Ryan-Fagan/QuadcopterPCB/docs/ComponentDiagram.png

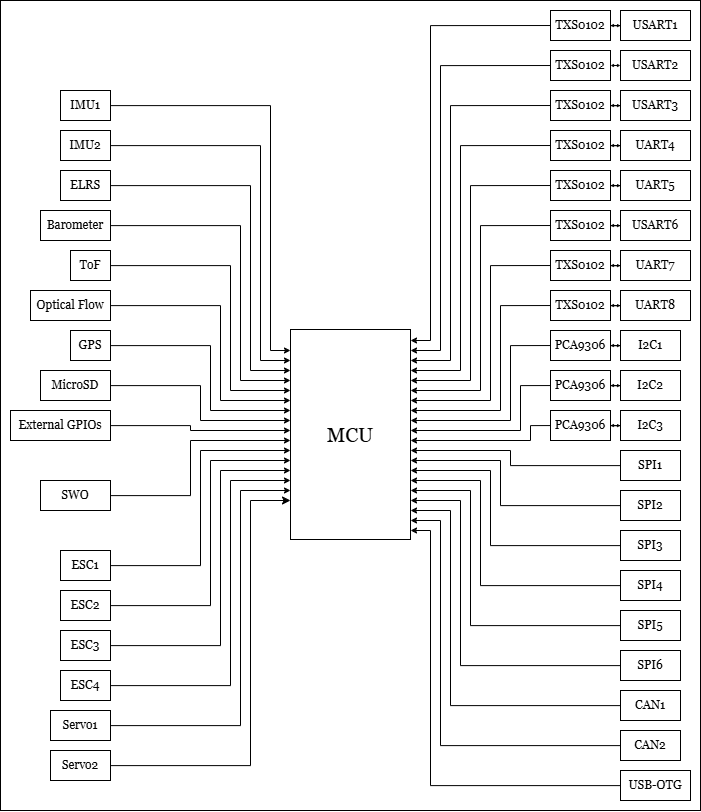
docs/ComponentDiagram.png
