Ryan-Fagan/QuadcopterPCB/docs/DroneSchematic.pdf

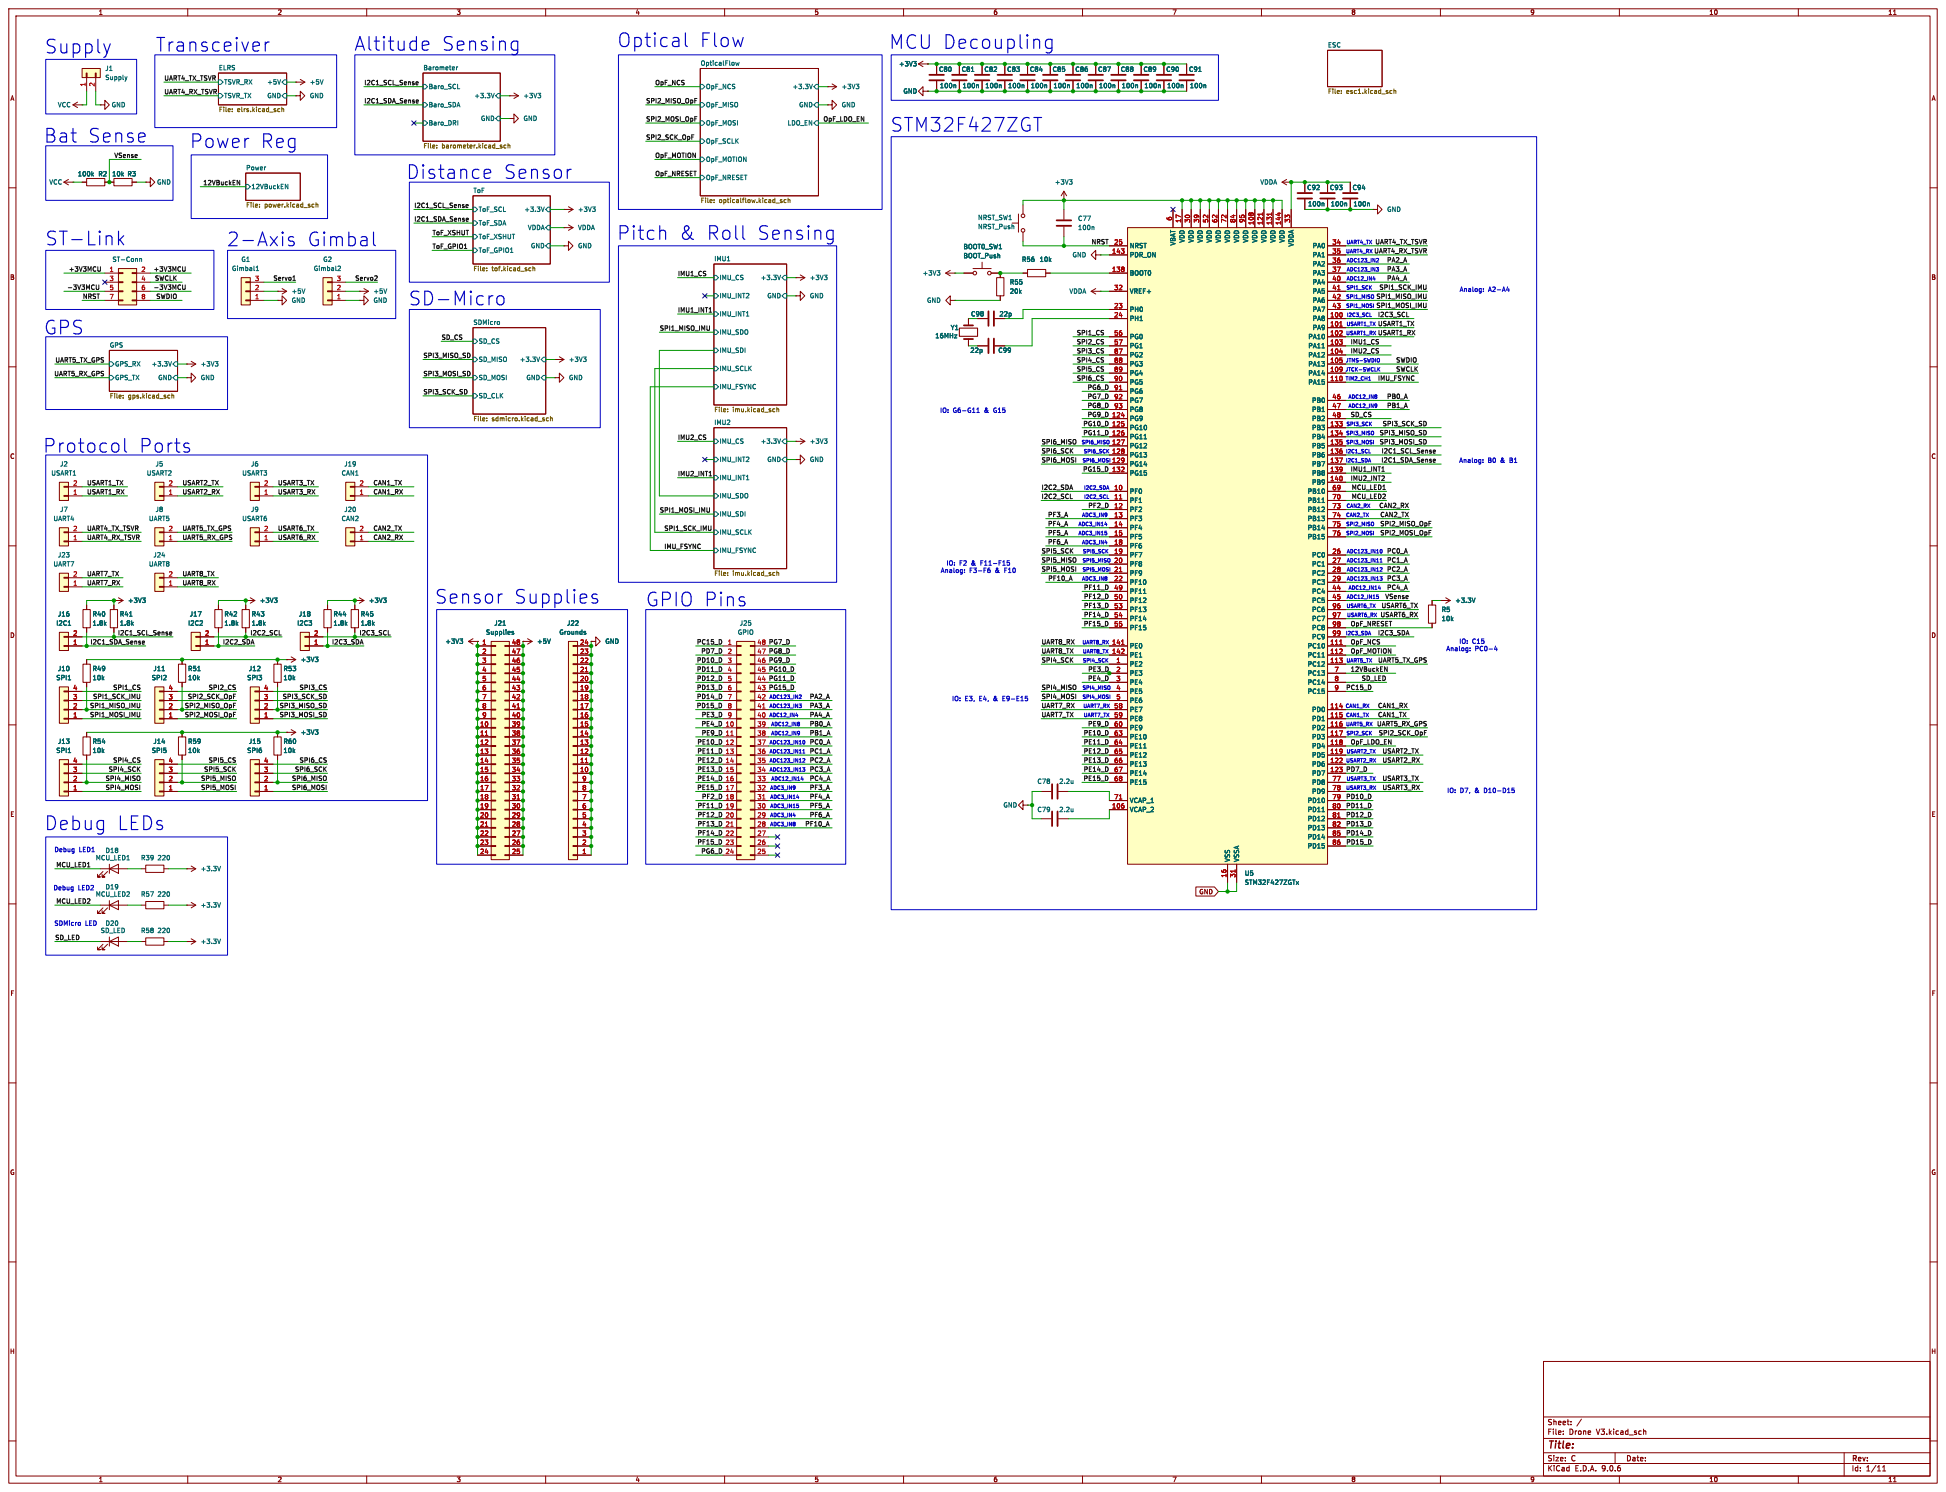
[picture p2: page 1]

JTCK-SWCLK Power Reg

6 VDD 17 VDD 30 VDD 39 VDD 52 VDD 62 VDD 72 VSS 16 VDD 84 VSSA 31 VDD 95 VDD 108 VDD 121 VDD 131 VDD 144 VDDA 33 PA0

Debug LED1 Debug LED2 SDMicro LED

Id: 1/11 Title: File: Drone V3.kicad_sch Sheet: /

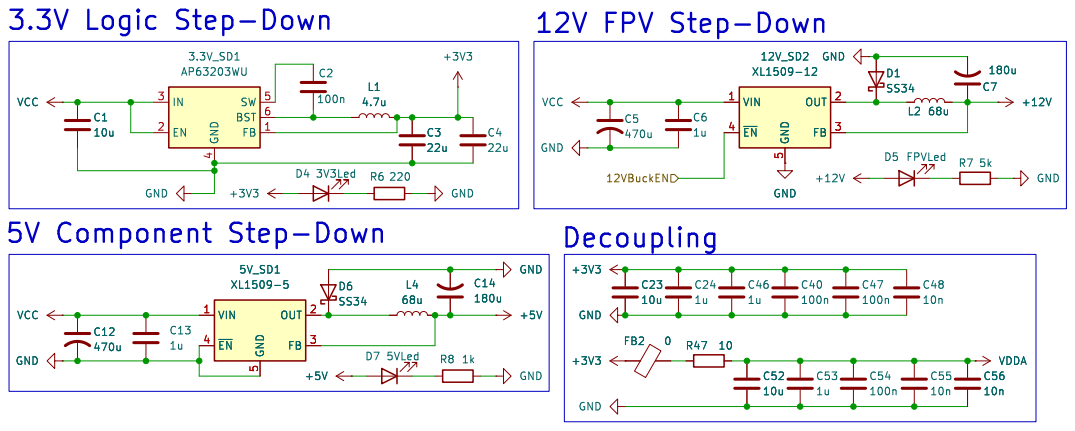
[picture p3: page 2]

Id: 2/11 Title: File: power.kicad_sch Sheet: /Power/

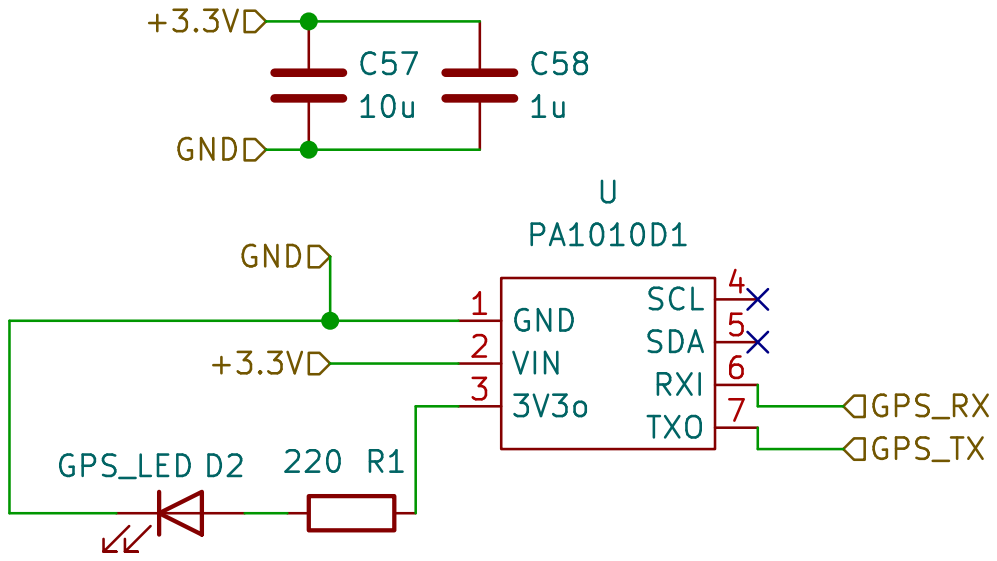
[picture p4: page 3]

Id: 3/11 Title: File: gps.kicad_sch Sheet: /GPS/

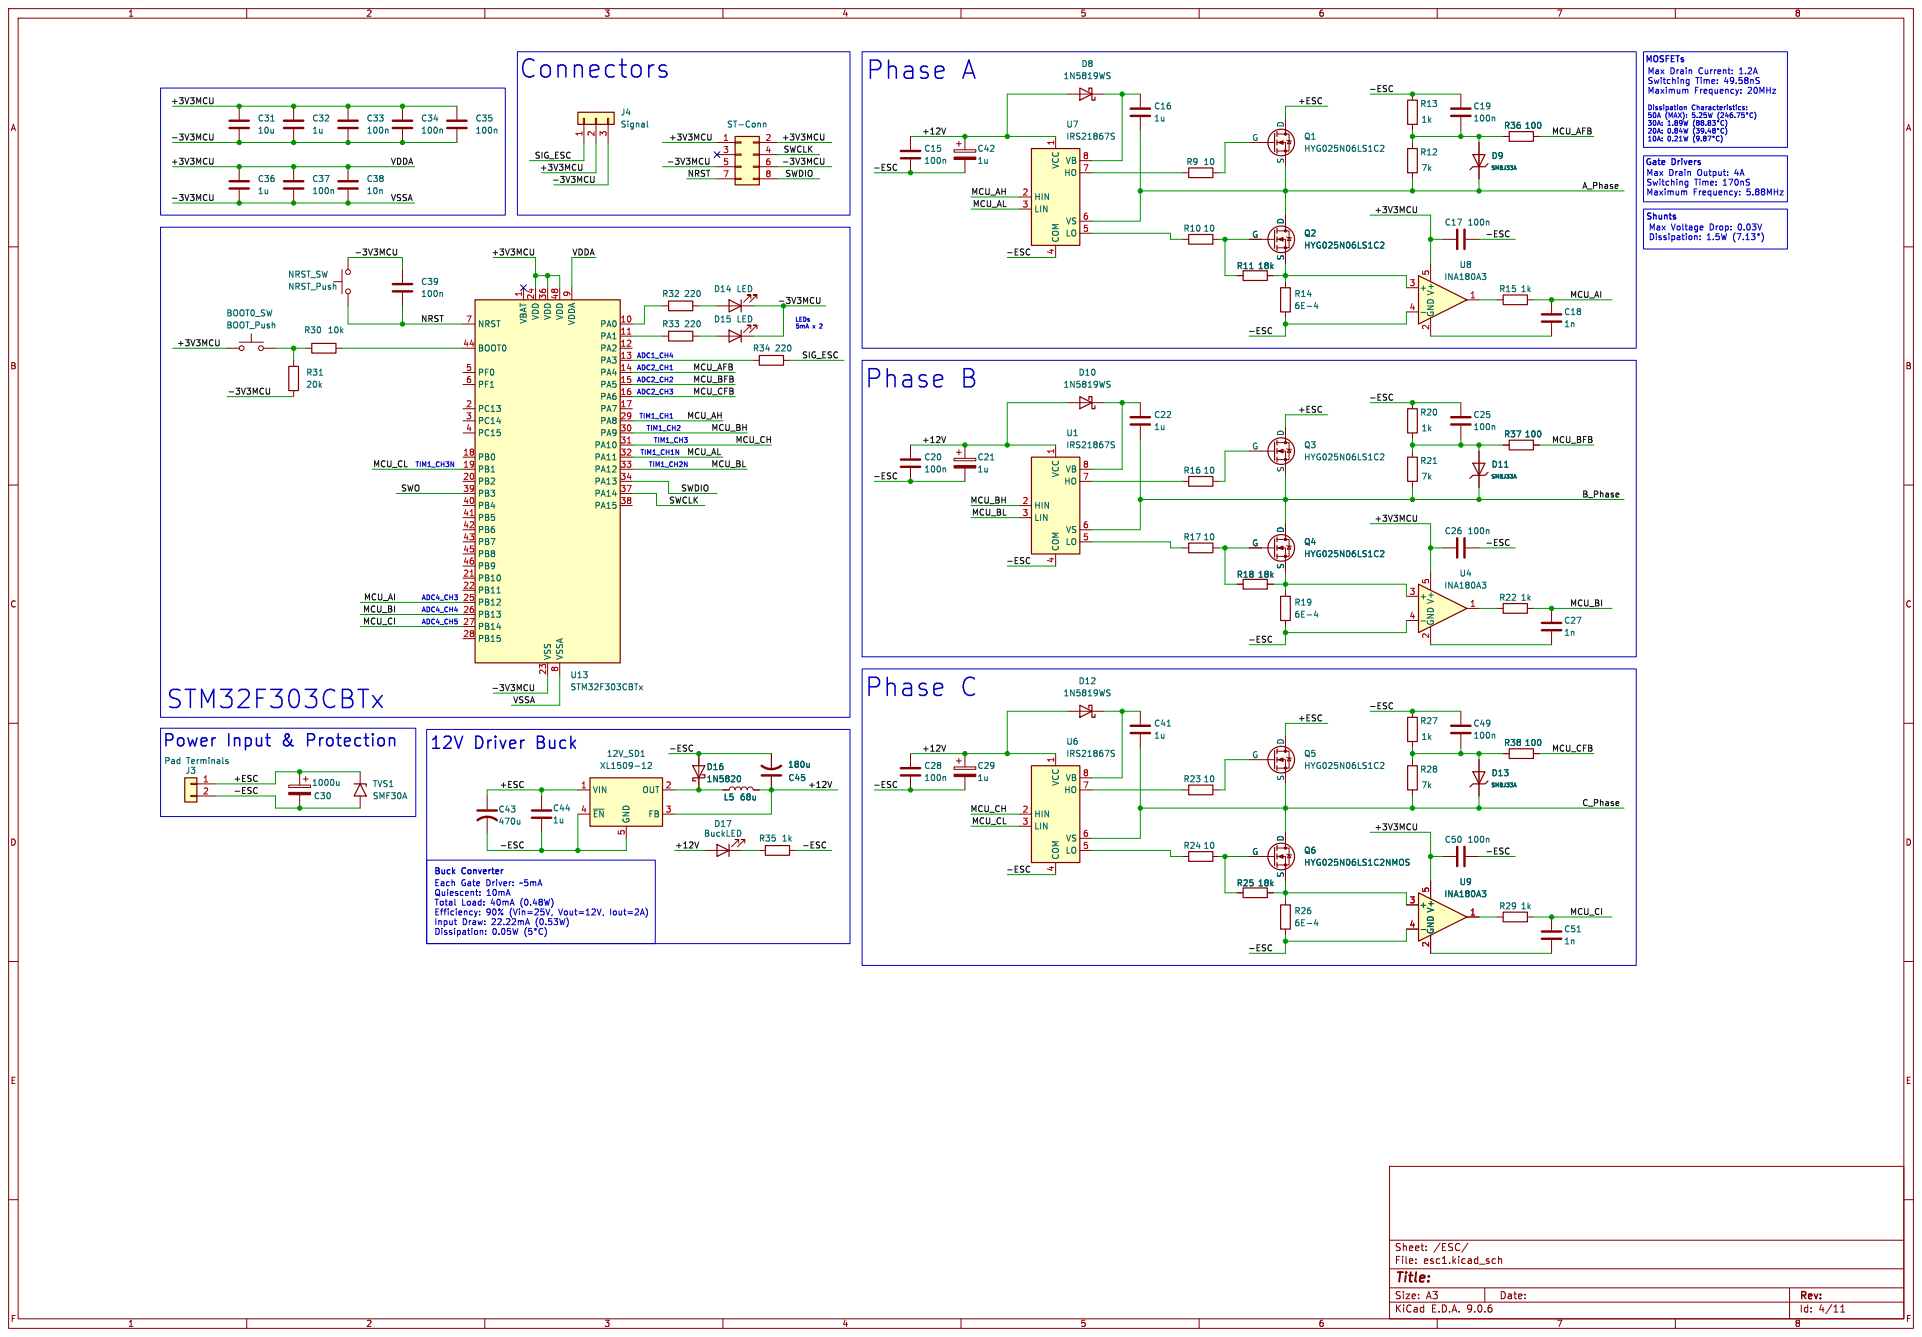
[picture p5: page 4]

1 VDD 24 VDD 36 VSS 23 VDD 48 VSSA

Id: 4/11 Title: File: esc1.kicad_sch Sheet: /ESC/

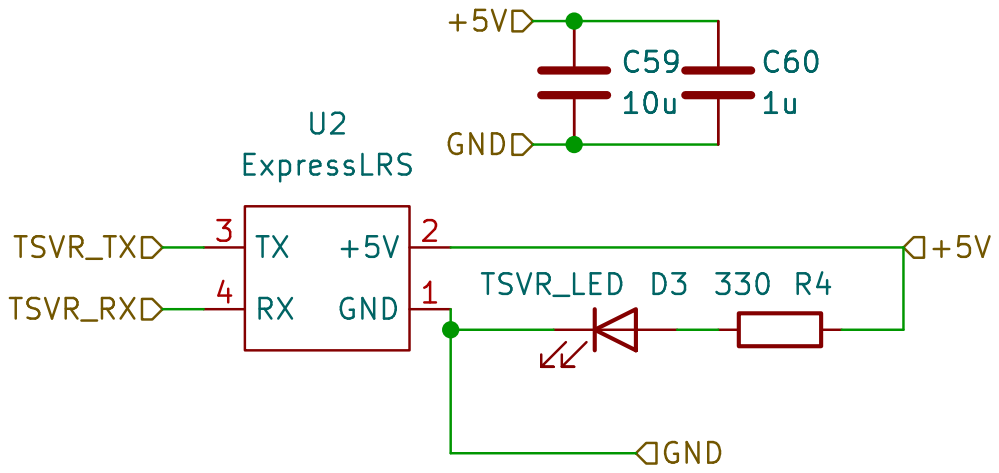
[picture p6: page 5]

Id: 5/11 Title: File: elrs.kicad_sch Sheet: /ELRS/

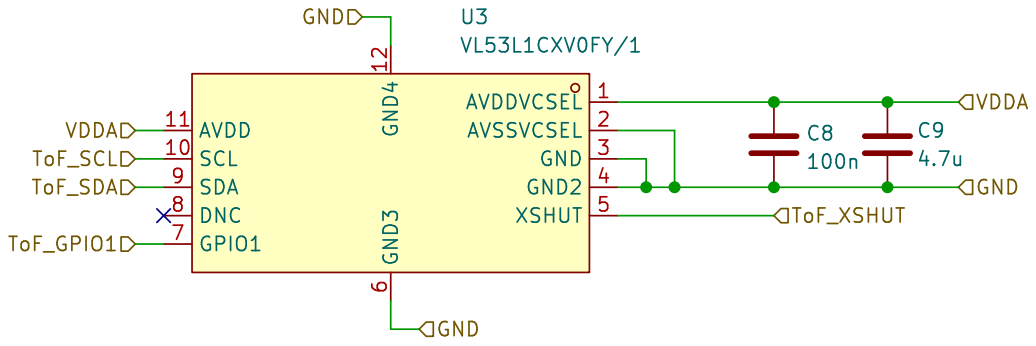
[picture p7: page 6]

6 GPIO1 7 DNC 8 XSHUT 5 SDA 9 GND2 4 SCL 10 GND 3 AVDD 11 AVSSVCSEL 2 AVDDVCSEL 1 GND4 12 U3VL53L1CXV0FY/1 C9

Id: 6/11 Title: File: tof.kicad_sch Sheet: /ToF/ C8

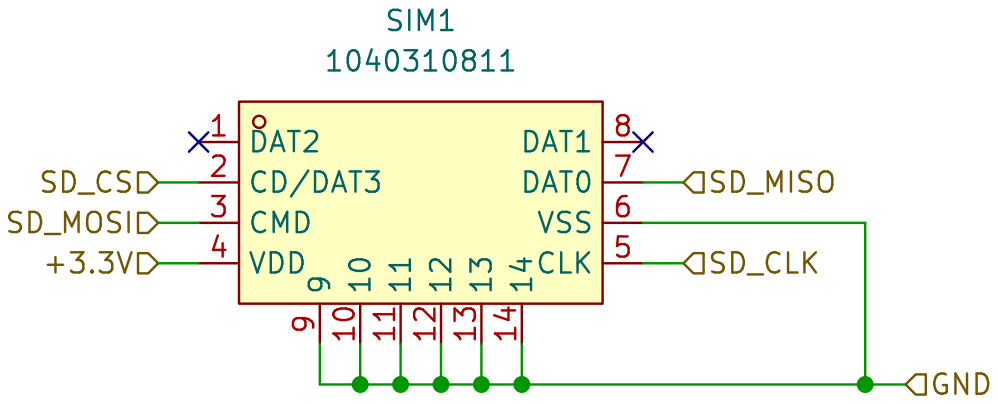
[picture p8: page 7]

Id: 7/11 Title: File: sdmicro.kicad_sch Sheet: /SDMicro/

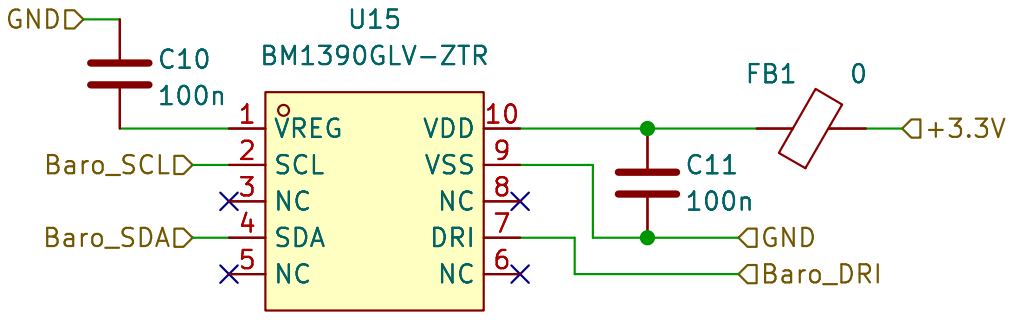
[picture p9: page 8]

Id: 8/11 Title: File: barometer.kicad_sch Sheet: /Barometer/

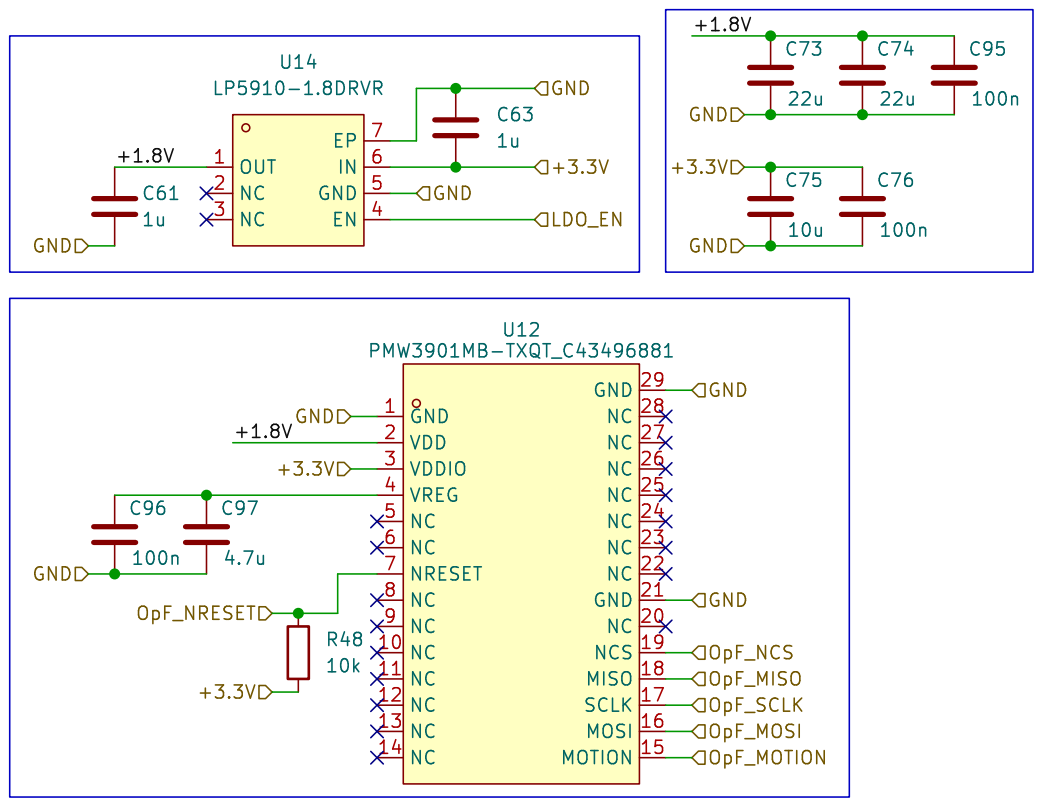
[picture p10: page 9]

Id: 11/11 Title: File: opticalflow.kicad_sch Sheet: /OpticalFlow/

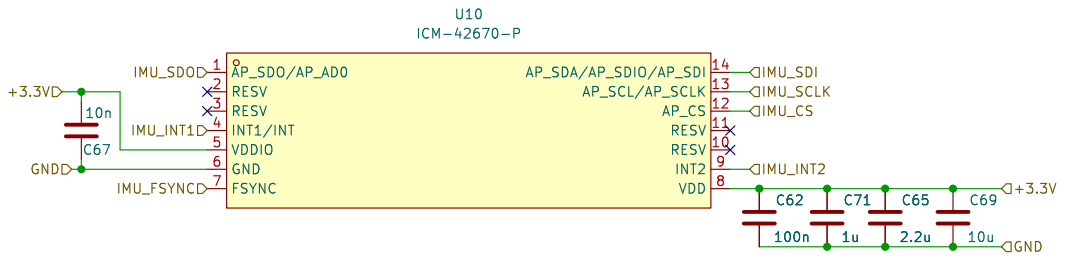
[picture p11: page 10]

Id: 11/11 Title: File: imu.kicad_sch Sheet: /IMU1/ C62

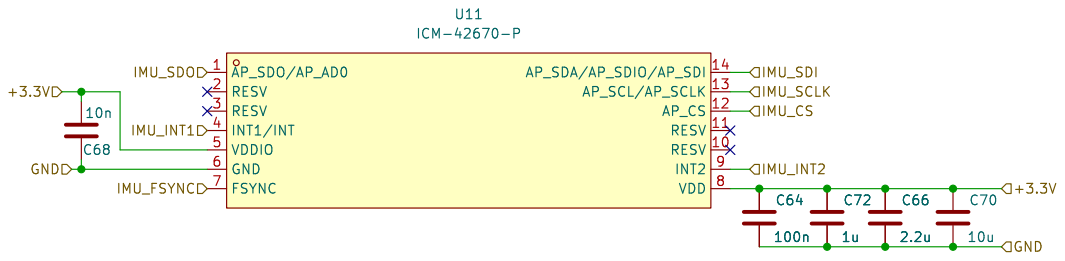
[picture p12: page 11]

Id: 12/11 Title: File: imu.kicad_sch Sheet: /IMU2/ C64
