Ryan-Fagan/QuadcopterPCB/(list of files, drawings)

Other design files:
freerouting.dsn
