Ryan-Fagan/QuadcopterPCB/Drone V3.kicad_pcb

## KiCad design Drone V3.kicad_pcb (2026-05-14)

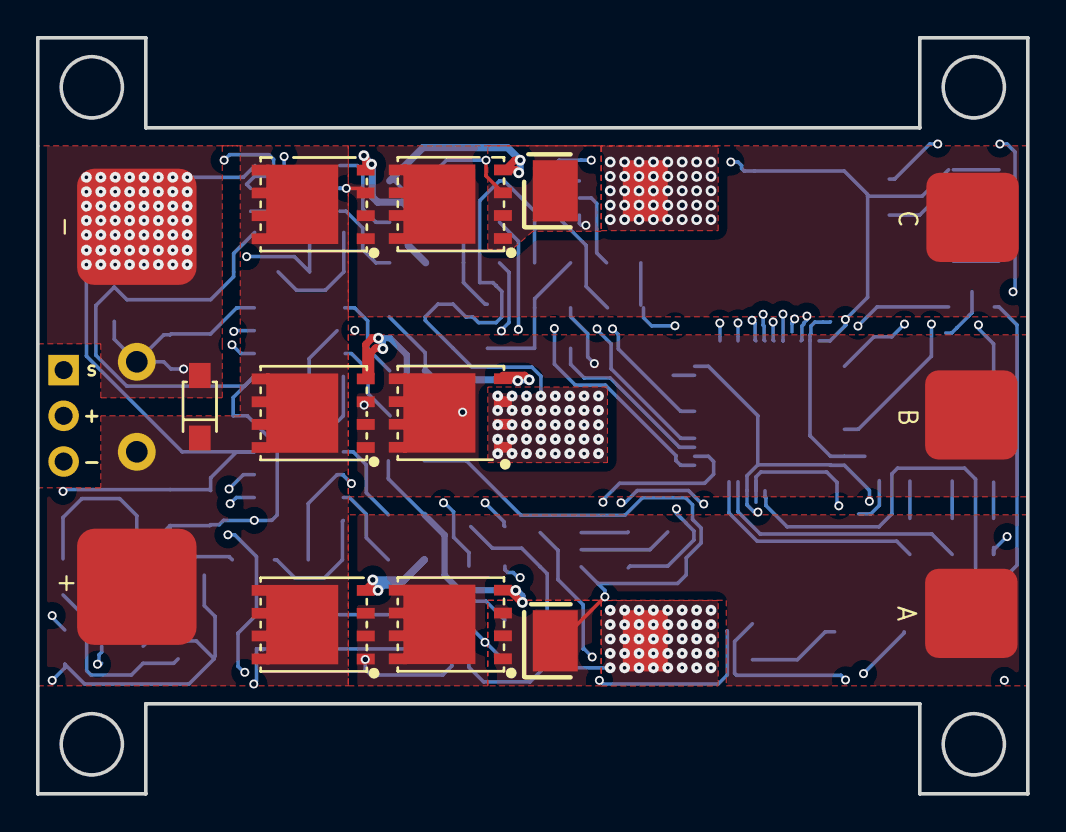
[picture p13: board Drone V3.kicad_pcb from above]

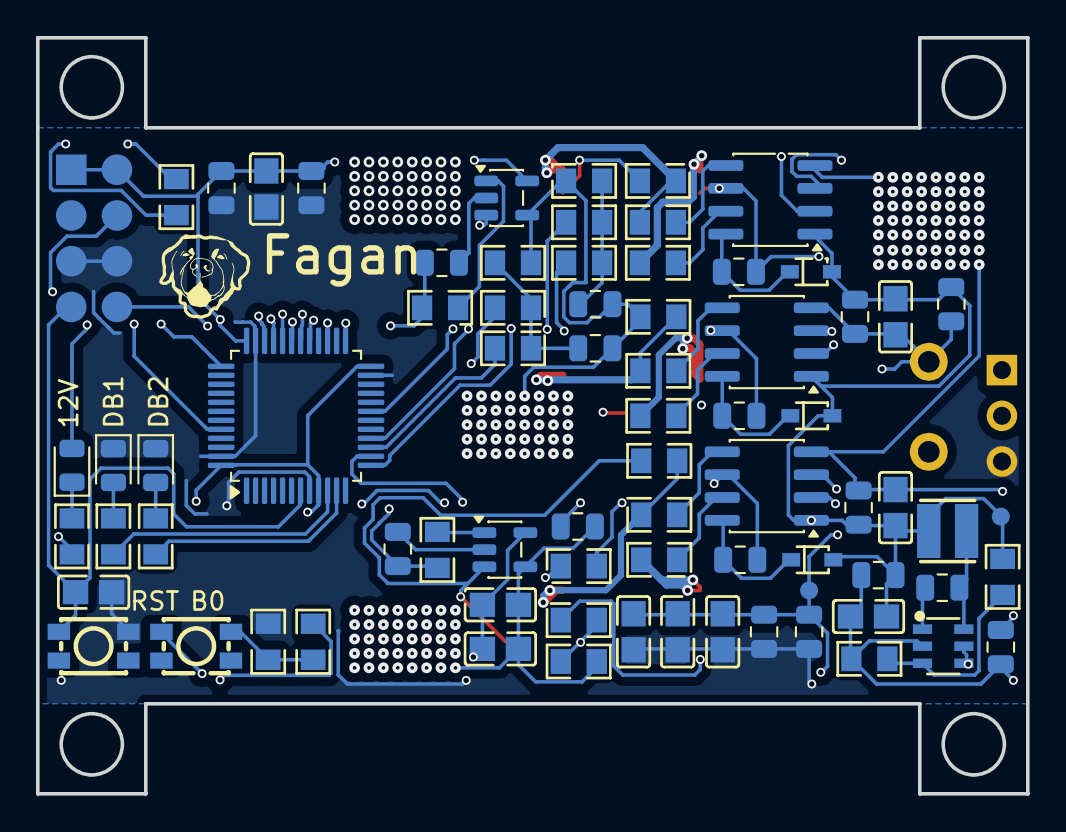
[picture p14: board Drone V3.kicad_pcb from below]

Board: 4 copper layers, 55.0 x 42.0 mm, 86 parts (75 on the bottom side), 59 nets.

Parts:
12V_SD1: TPS560430; SOT-23-6_L2.9-W1.6-P0.95-LS2.8-BL
B0: BOOT_Push; SW-SMD_4P-L3.5-W3.0-P1.50-LS4.7
C15, C20, C26, C28, C29, C33, C34, C35, C37, C39: 100n; C0805
C16, C21, C22, C23, C24, C32, C36, C41: 1u; C_0805_2012Metric
C19, C25, C27, C40, C49: 22n; C_0805_2012Metric
C30: 1000u; CAP-TH_BD12.5-P5.00-D0.6-FD
C31, C45: 10u; C_0805_2012Metric
C38: 10n; C_0805_2012Metric
C42: 2.2u; C_0805_2012Metric
C43: 100n; C_0805_2012Metric
D8, D10, D12: 1N5819WS; SOD-323_L1.8-W1.3-LS2.5-RD
D14, D15: LED; LED_0805_2012Metric
D17: BuckLED; LED_0805_2012Metric
J2: Phase Outputs; ESC Outputs
J3: Pad Terminals; Battery Inputs
J4: Signal; PinHeader_1x03_P2.54mm_Horizontal
L6: 33u; IND-SMD_L3.0-W3.0_LQH3NPN2R2NG0L
NMOS1, NMOS2, NMOS3, NMOS4, NMOS5, NMOS6: HYG025N06LS1C2; DFN-8_L5.9-W5.2-P1.27-LS6.2-BL
R9, R10, R16, R17, R23, R24: 10; R0805
R11, R18, R25, R31: 47k; R0805
R12, R21, R28: 36k; R0805
R13, R20, R27, R30, R35: 5k; R0805
R19, R26: 6E-4; RES-SMD_L6.4-W3.2_LRS2512
R22, R29, R32, R33, R34, R36, R37, R38: 220; R0805
R39: 243; R0805
R40: 22.1; R0805
RST: NRST_Push; SW-SMD_4P-L3.5-W3.0-P1.50-LS4.7
ST-Link1: ST-Conn; PinHeader_2x04_P2.54mm_Vertical
TVS1: SMF30A; SOD-123FL_L2.7-W1.8-LS3.8-RD
U1, U6, U7: IRS21867S; SOIC-8_3.9x4.9mm_P1.27mm
U4, U9: INA180A3; SOT-23-5
U13: STM32F303CBTx; LQFP-48_7x7mm_P0.5mm

Connections:
/ESC1/+3V3MCU: B0.1, C26.1, C29.1, C31.1, C32.1, C33.1, C34.1, C35.1, C36.1, C37.1, C38.1, J4.2, ST-Link1.1, ST-Link1.2, U4.5 (V+), U9.5 (V+), U13.9 (VDDA), U13.24 (VDD), U13.36 (VDD), U13.48 (VDD)
/ESC1/+12V: C15.1, C20.1, C21.1, C23.1, C24.1, C28.1, C45.1, D8.2 (A), D10.2 (A), D12.2 (A), D17.2 (A), L6.2, R39.1, U1.1 (VCC), U6.1 (VCC), U7.1 (VCC)
/ESC1/+ESC: C30.1, J3.1, NMOS1.1 (D), NMOS3.1 (D), NMOS5.1 (D), TVS1.1 (A1)
/ESC1/-3V3MCU: C31.2, C32.2, C33.2, C34.2, C35.2, C36.2, C37.2, C38.2, C39.1, D14.1 (K), D15.1 (K), J4.3, R31.1, RST.2, ST-Link1.5, ST-Link1.6, U13.8 (VSSA), U13.23 (VSS), U13.35 (VSS), U13.47 (VSS)
/ESC1/-ESC: 12V_SD1.2 (GND), C15.2, C19.1, C20.2, C21.2, C23.2, C24.2, C25.1, C26.2, C28.2, C29.2, C30.2, C42.2, C45.2, C49.1, J3.2, NMOS4.3 (S), R13.1, R18.2, R19.2, R20.1, R26.2, R27.1, R35.2, R40.2, TVS1.2 (A2), U1.4 (COM), U4.4 (-), U6.4 (COM), U7.4 (COM), U9.4 (-)
/ESC1/A_Phase: C16.2, J2.1, NMOS1.3 (S), NMOS2.1 (D), R12.2, U7.6 (VS)
/ESC1/BUCK_FB: 12V_SD1.3 (FB), R39.2, R40.1
/ESC1/BUCK_SW: 12V_SD1.6 (SW), C43.1, L6.1
/ESC1/B_Phase: C22.2, J2.2, NMOS3.3 (S), NMOS4.1 (D), R21.2, U1.6 (VS)
/ESC1/C_Phase: C41.2, J2.3, NMOS5.3 (S), NMOS6.1 (D), R28.2, U6.6 (VS)
/ESC1/MCU_AFB: R36.2, U13.14 (PA4)
/ESC1/MCU_AH: U7.2 (HIN), U13.29 (PA8)
/ESC1/MCU_AI: C40.1, R29.2, U13.25 (PB12)
/ESC1/MCU_AL: U7.3 (LIN), U13.32 (PA11)
/ESC1/MCU_BFB: R37.2, U13.15 (PA5)
/ESC1/MCU_BH: U1.2 (HIN), U13.30 (PA9)
/ESC1/MCU_BL: U1.3 (LIN), U13.33 (PA12)
/ESC1/MCU_CFB: R38.2, U13.16 (PA6)
/ESC1/MCU_CH: U6.2 (HIN), U13.31 (PA10)
/ESC1/MCU_CI: C27.1, R22.2, U13.27 (PB14)
/ESC1/MCU_CL: U6.3 (LIN), U13.19 (PB1)
/ESC1/NRST: C39.2, RST.1, ST-Link1.7, U13.7 (NRST)
/ESC1/SIG_ESC: J4.1, R34.2
/ESC1/SWCLK: ST-Link1.4, U13.37 (PA14)
/ESC1/SWDIO: ST-Link1.8, U13.34 (PA13)
/ESC1/Shunt_A: NMOS2.3 (S), R11.2, R26.1, U9.3 (+)
/ESC1/Shunt_C: NMOS6.3 (S), R19.1, R25.2, U4.3 (+)
unnamed: 12V_SD1.1 (CB), C43.2
unnamed: 12V_SD1.4 (EN), 12V_SD1.5 (VIN), C42.1
unnamed: B0.2, R30.1, R31.2
unnamed: C19.2, R12.1, R13.2, R36.1
unnamed: C25.2, R20.2, R21.1, R37.1
unnamed: C49.2, R27.2, R28.1, R38.1
unnamed: C16.1, D8.1 (K), U7.8 (VB)
unnamed: C22.1, D10.1 (K), U1.8 (VB)
unnamed: C41.1, D12.1 (K), U6.8 (VB)
unnamed: D14.2 (A), R32.2
unnamed: D15.2 (A), R33.2
unnamed: D17.1 (K), R35.1
unnamed: NMOS1.2 (G), R9.2
unnamed: NMOS2.2 (G), R10.2, R11.1
unnamed: NMOS3.2 (G), R16.2
unnamed: NMOS4.2 (G), R17.2, R18.1
unnamed: NMOS5.2 (G), R23.2
unnamed: NMOS6.2 (G), R24.2, R25.1
unnamed: R22.1, U4.1
unnamed: R29.1, U9.1
unnamed: R16.1, U1.7 (HO)
unnamed: R17.1, U1.5 (LO)
unnamed: C27.2, U4.2 (GND)
unnamed: R23.1, U6.7 (HO)
unnamed: R24.1, U6.5 (LO)
unnamed: R9.1, U7.7 (HO)
unnamed: R10.1, U7.5 (LO)
unnamed: C40.2, U9.2 (GND)
unnamed: R30.2, U13.44 (BOOT0)
unnamed: R32.1, U13.10 (PA0)
unnamed: R33.1, U13.11 (PA1)
unnamed: R34.1, U13.13 (PA3)
