Ryan-Fagan/QuadcopterPCB/(commit log)

2025-11-05 Project Upload
    [Drone V3.kicad_pcb, Drone V3.kicad_sch, esc1.kicad_sch, gps.kicad_sch, phase_a.kicad_sch, power.kicad_sch, untitled.kicad_sch]
2025-11-06 ESC Schematic Update
    [esc1.kicad_sch]
2025-11-12 ESC Update with Specifications
    [esc1.kicad_sch, gps.kicad_sch, power.kicad_sch]
2025-11-12 ESC Final Draft 1
    [esc1.kicad_sch]
2025-11-17 ESC Update
    [esc1.kicad_sch]
2025-11-24 ESC Update & Finalization Draft
    [esc1.kicad_sch, gps.kicad_sch, power.kicad_sch]
2025-12-31 Less bulky switching regulator for the ESC drivers, PCB update.
    [Drone V3.kicad_pcb, esc1.kicad_sch, gps.kicad_sch, power.kicad_sch]
2026-01-18 Drone PCB Update
    [Drone V3.kicad_pcb, Drone V3.kicad_sch]
2026-01-31 ESC Routing, MOS Footprint Change
    [Drone V3.kicad_pcb]
2026-02-01 Routing Update. Signal powers routed except for MCU. Look for unrouted traces without vias. Vias for signal lines added for organization
    [Drone V3.kicad_pcb, esc1.kicad_sch]
2026-04-01 Update Type stuff
    [Drone V3.kicad_pcb, esc1.kicad_sch]
2026-04-09 Done with routing, partial review complete.
    [Drone V3.kicad_pcb]
2026-04-09 Final draft
    [Drone V3.kicad_pcb]
2026-05-14 ESC PCB Finalized Iteration #1
    [Drone V3.kicad_pcb, esc1.kicad_sch]
2026-05-14 Custom Symbols & Footprints import
2026-05-14 Sensors & Main board start
    [barometer.kicad_sch, elrs.kicad_sch, esc1.kicad_sch, gps.kicad_sch, imu.kicad_sch, magnetometer.kicad_sch, sdmicro.kicad_sch, tof.kicad_sch]
2026-05-14 Library update with new symbols & footprints
2026-05-14 Initial component symbol placement
    [barometer.kicad_sch, imu.kicad_sch, magnetometer.kicad_sch, sdmicro.kicad_sch, tof.kicad_sch]
2026-05-15 Barometer & ToF Hierarchical Schematic Updates
    [barometer.kicad_sch, sdmicro.kicad_sch, tof.kicad_sch]
2026-05-18 MCU implementation start Still needs component schematic checks & component integration with MCU
    [Drone V3.kicad_sch, barometer.kicad_sch, elrs.kicad_sch, gps.kicad_sch, imu.kicad_sch, magnetometer.kicad_sch, power.kicad_sch, sdmicro.kicad_sch]
2026-05-21 Main Schematic update, Magnetometer deletions, Protocol connections, & External sensor compatibilities progress.
    [Drone V3.kicad_sch, freerouting.dsn, opticalflow.kicad_sch]
2026-05-21 GPS Schematic Update
    [gps.kicad_sch]
2026-05-26 MCU Integration & Sensor Ports
    [Drone V3.kicad_sch, barometer.kicad_sch, opticalflow.kicad_sch, sdmicro.kicad_sch, tof.kicad_sch]
2026-05-28 USB C integration, 5V tolerances on UART ports, digital pins, and analog pins.
    [Drone V3.kicad_sch]
